radularisaa/Arduino-maze-game/Img/2.jpeg

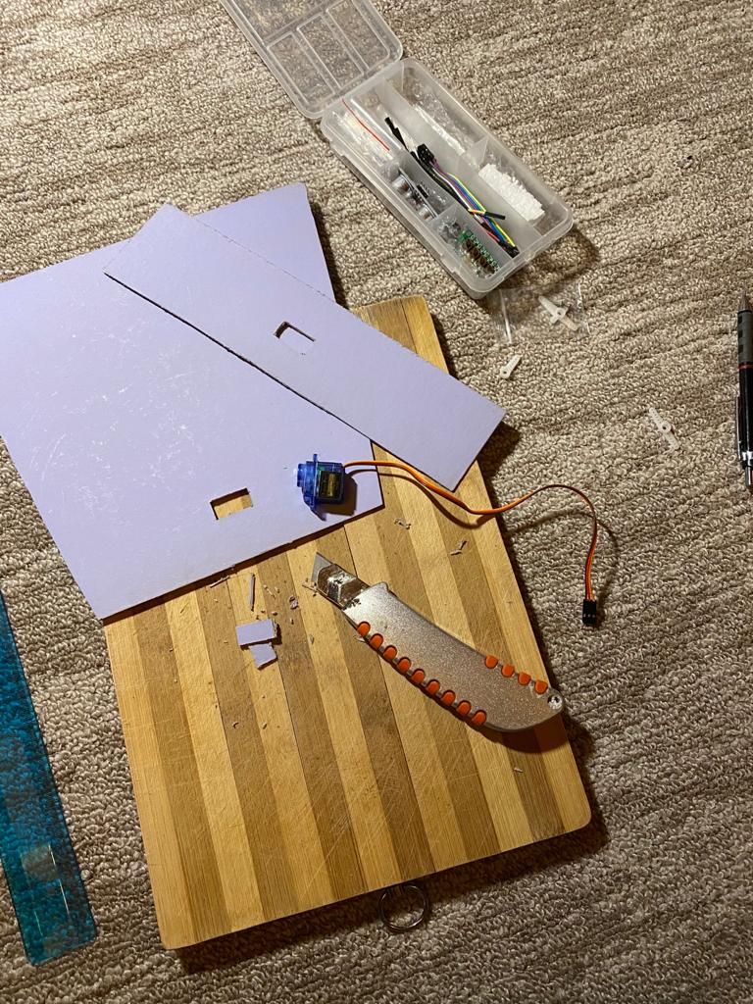
Img/2.jpeg
