radularisaa/Arduino-maze-game/Img/15.jpeg

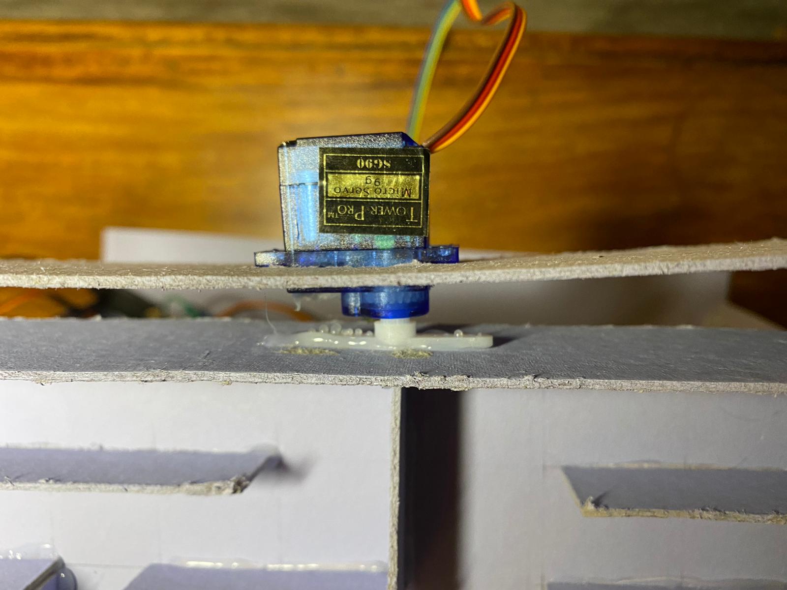
Img/15.jpeg
