radularisaa/Arduino-maze-game/README.md

# Arduino-maze-game

This is a fun maze game made with arduino components and carboard. Enjoy!

Video de prezentare construcție: https://youtu.be/x9sQN4BVw8w 

Video de prezentare funcționare: https://youtu.be/sFMINSDa4Wc 

Video cu explicația codului: https://youtu.be/Gt4K3H8ZN_Y
