radularisaa/Arduino-maze-game/Img/1.jpeg

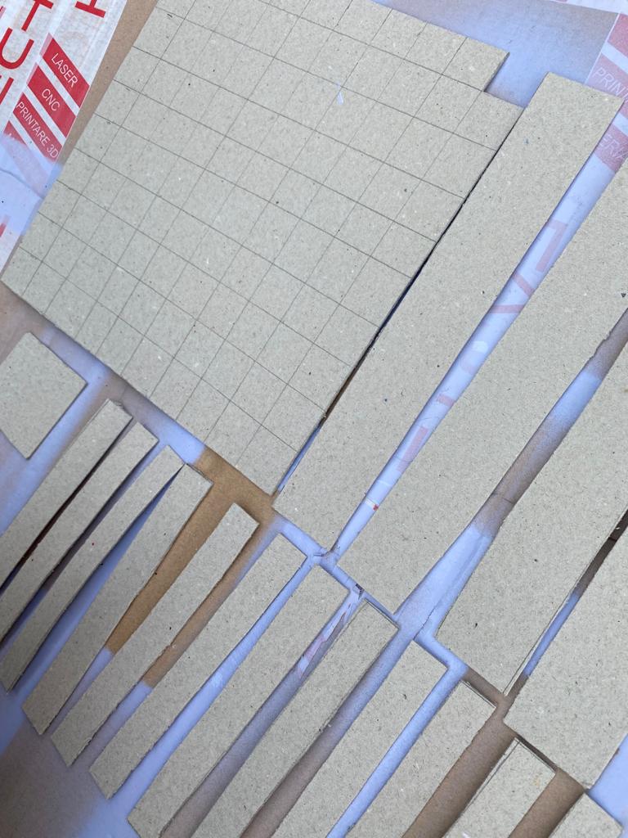
Img/1.jpeg
