radularisaa/Arduino-maze-game/Img/3.jpeg

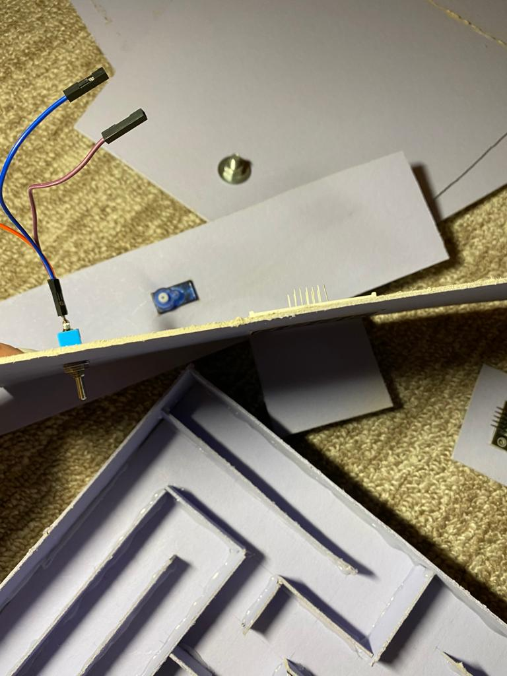
Img/3.jpeg
