radularisaa/Arduino-maze-game/Img/5.jpeg

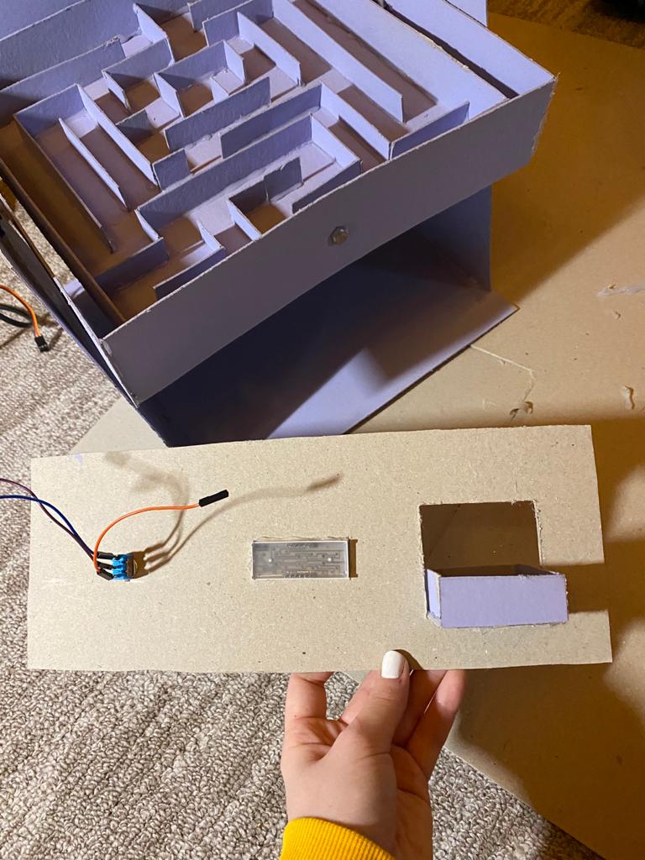
Img/5.jpeg
