radularisaa/Arduino-maze-game/Img/6.jpeg

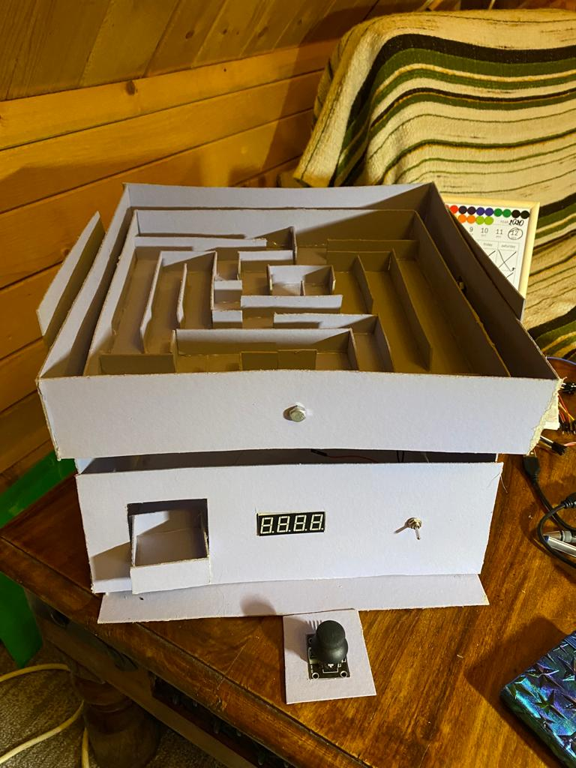
Img/6.jpeg
