radularisaa/Arduino-maze-game/Img/7.jpeg

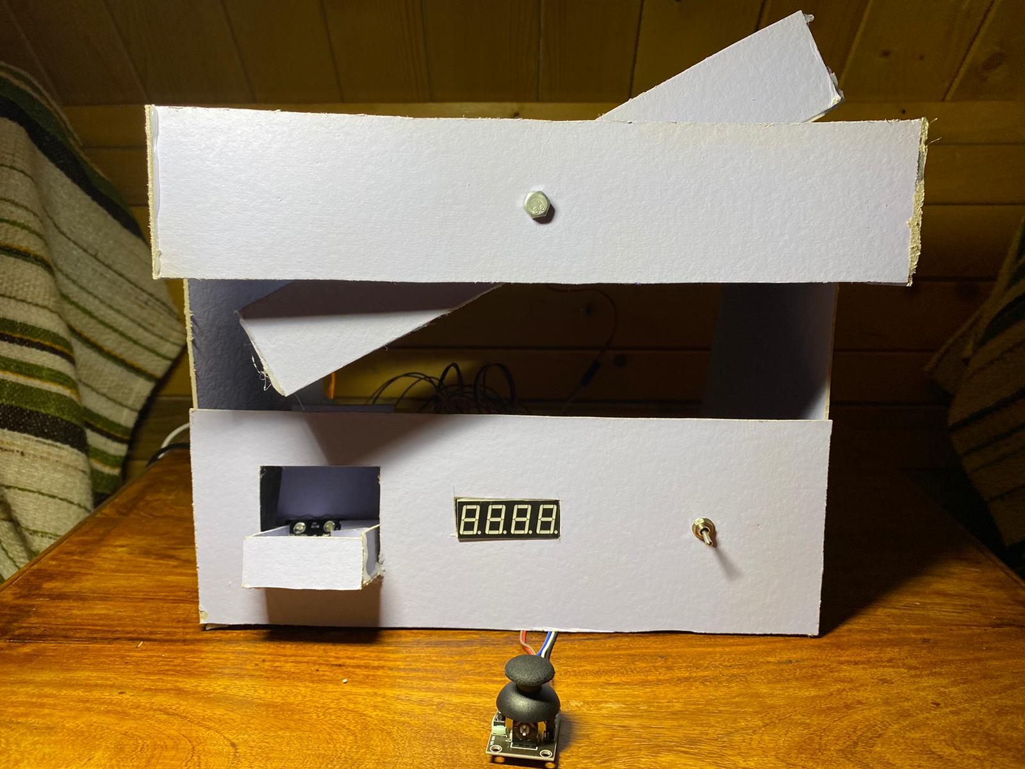
Img/7.jpeg
