radularisaa/Arduino-maze-game/Img/8.jpeg

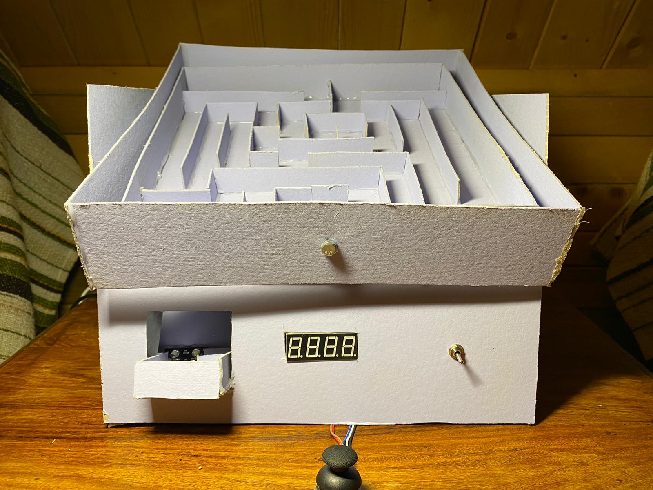
Img/8.jpeg
