radularisaa/Arduino-maze-game/Img/9.jpeg

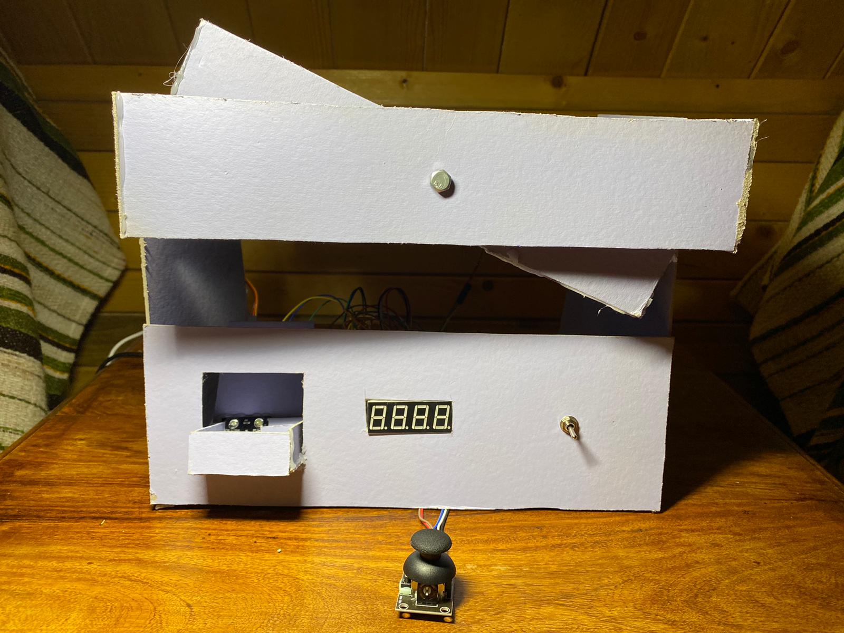
Img/9.jpeg
