radularisaa/Arduino-maze-game/Img/10.jpeg

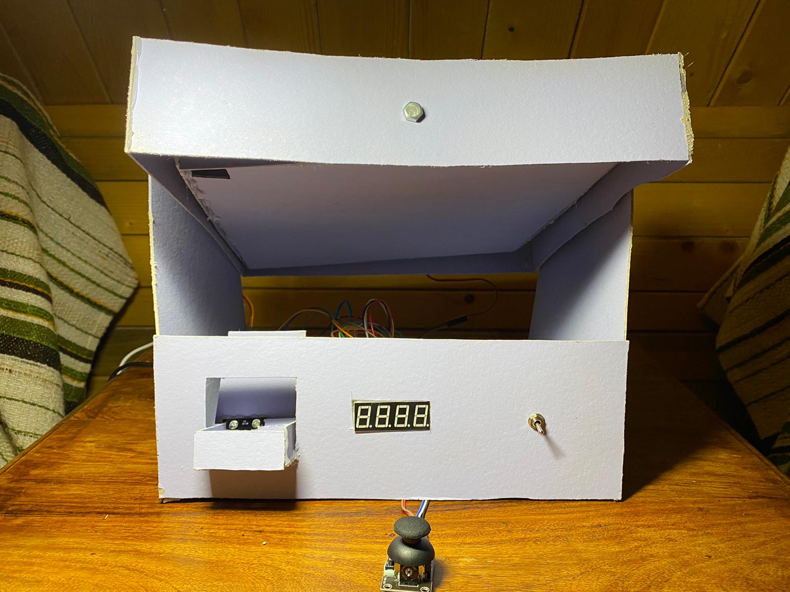
Img/10.jpeg
