radularisaa/Arduino-maze-game/Img/11.jpeg

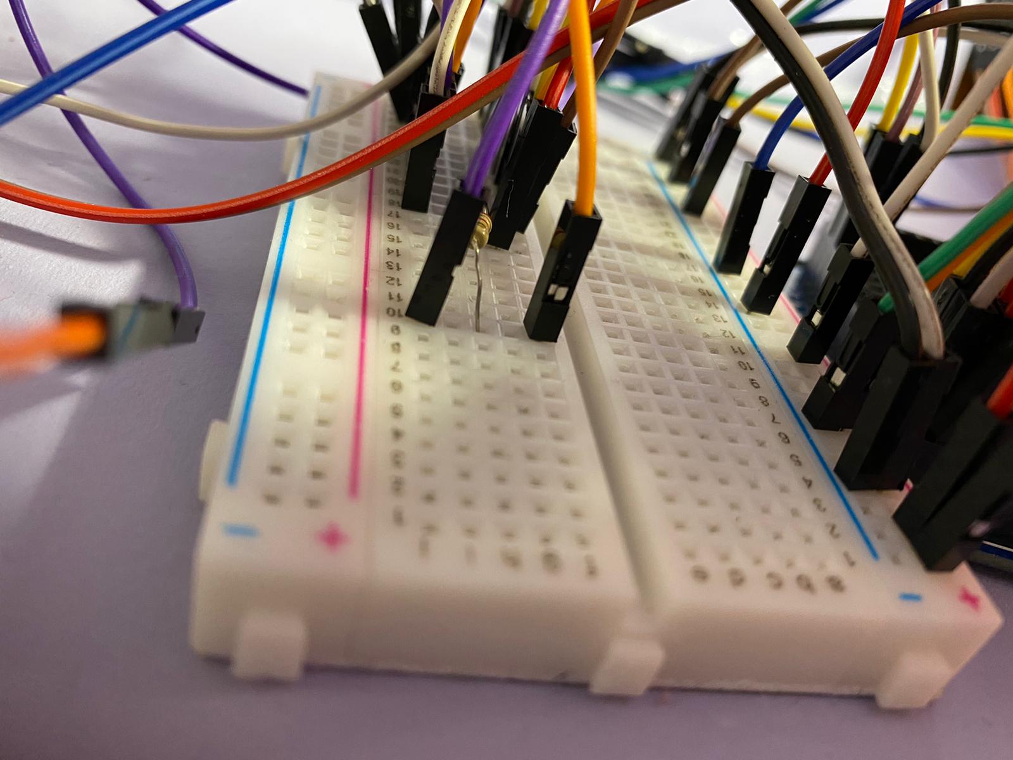
Img/11.jpeg
