radularisaa/Arduino-maze-game/Img/12.jpeg

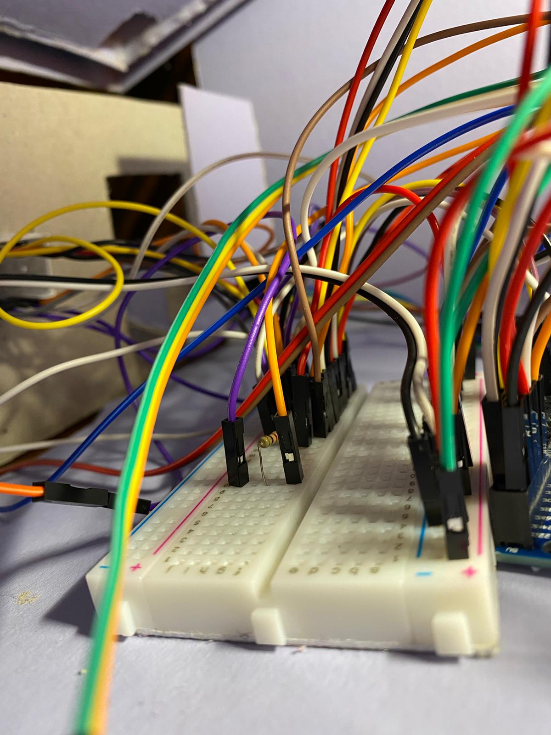
Img/12.jpeg
