radularisaa/Arduino-maze-game/Img/13.jpeg

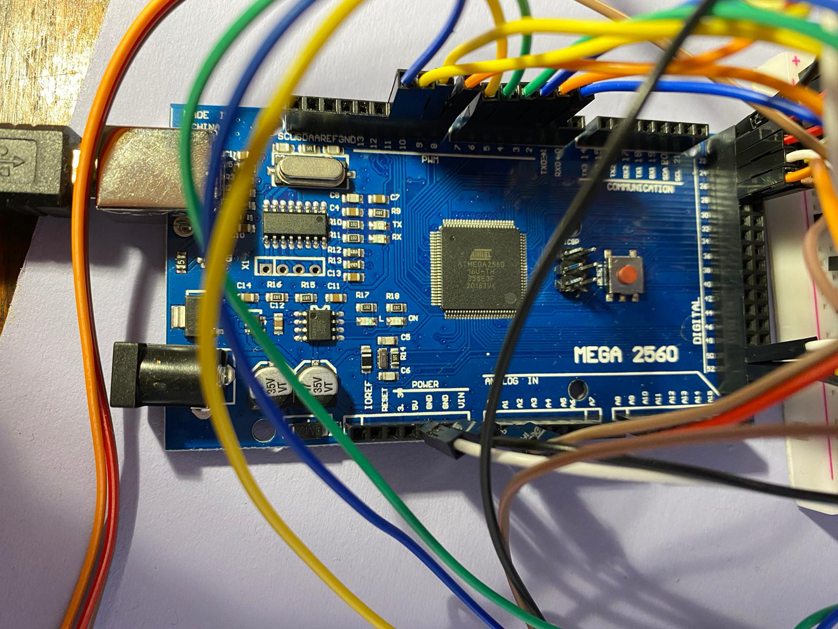
Img/13.jpeg
