radularisaa/Arduino-maze-game/Img/16.jpeg

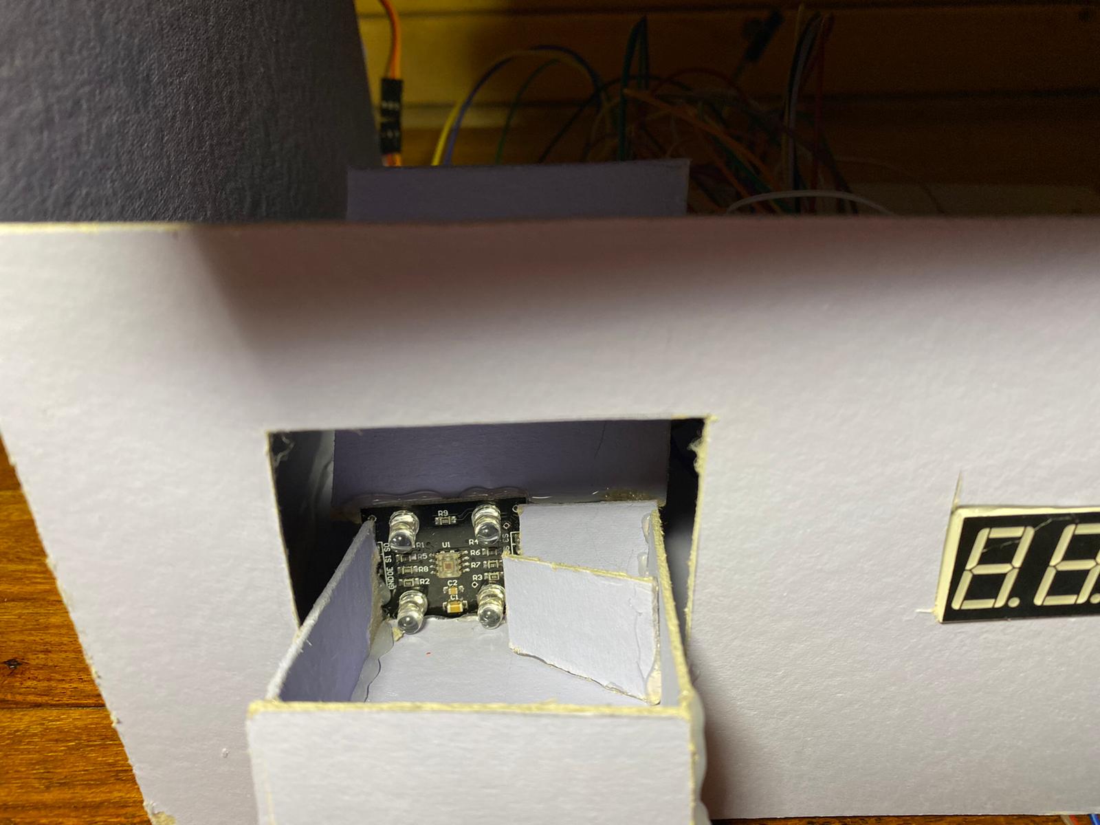
Img/16.jpeg
