radularisaa/Arduino-maze-game/Img/17.jpeg

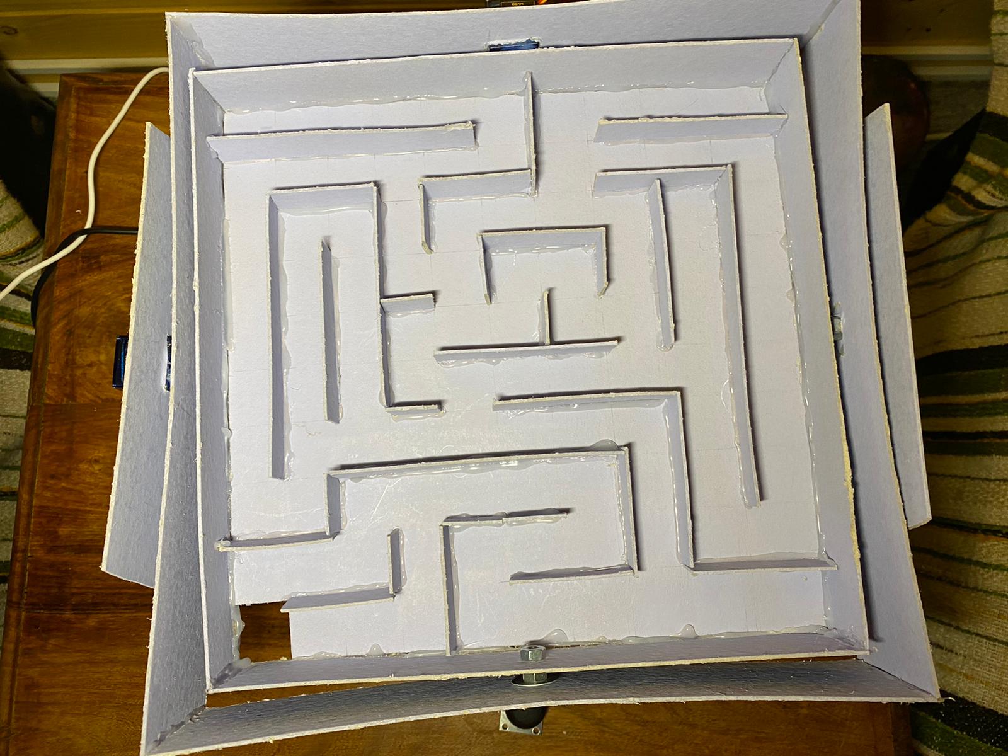
Img/17.jpeg
