radularisaa/Arduino-maze-game/Img/18.jpeg

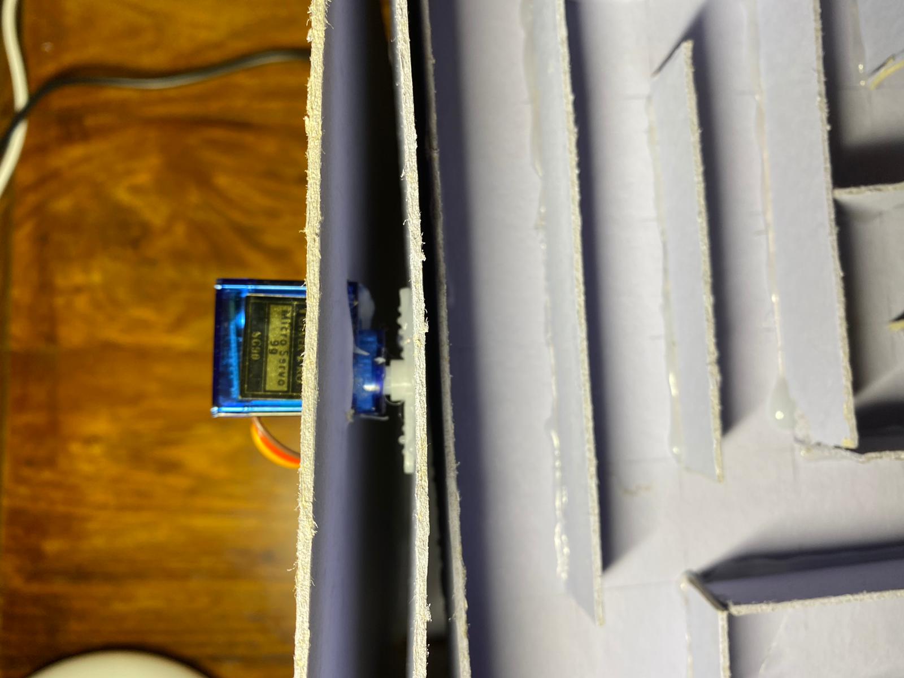
Img/18.jpeg
