radularisaa/Arduino-maze-game/Img/19.jpeg

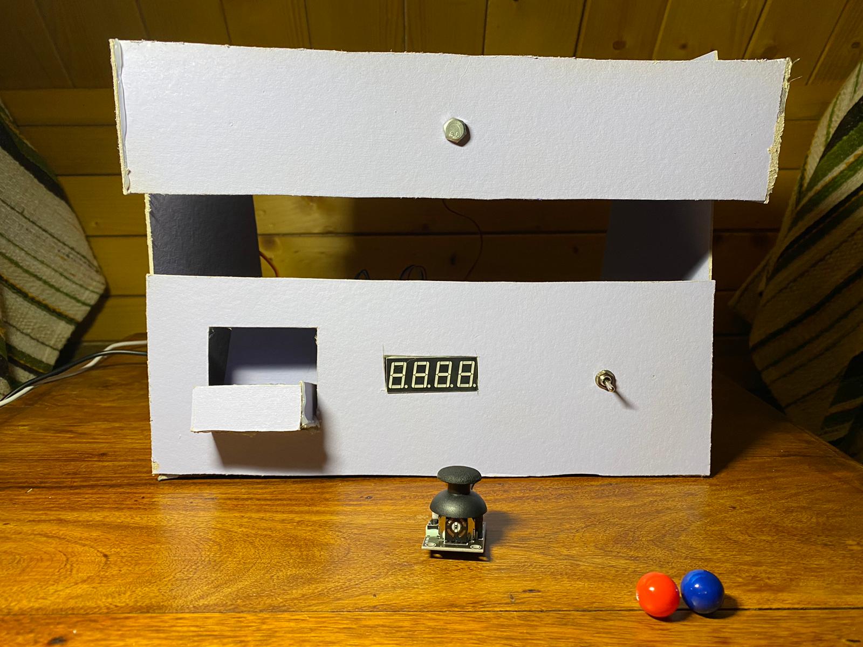
Img/19.jpeg
