radularisaa/Arduino-maze-game/Img/20.jpeg

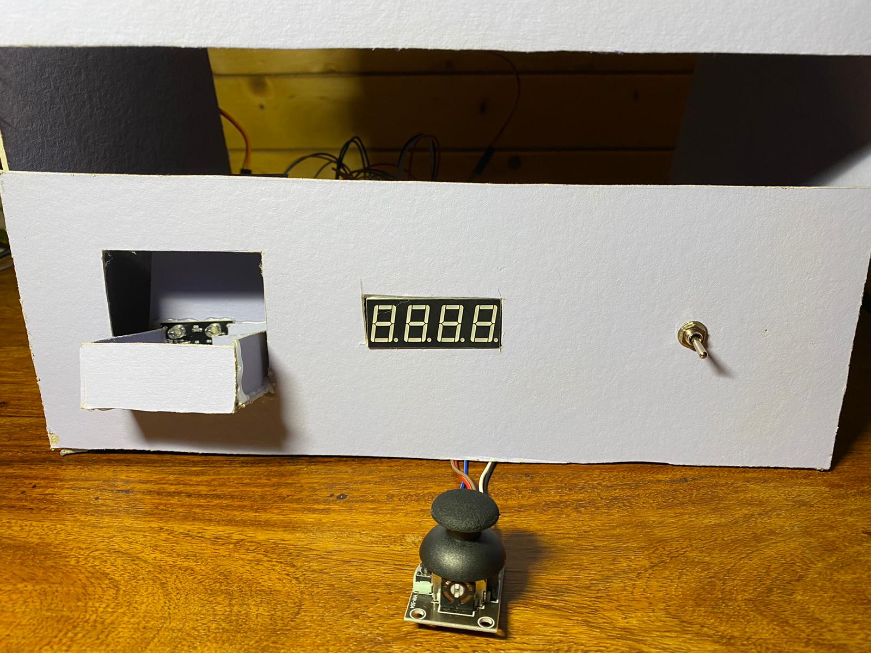
Img/20.jpeg
