radularisaa/Arduino-maze-game/Img/21.jpeg

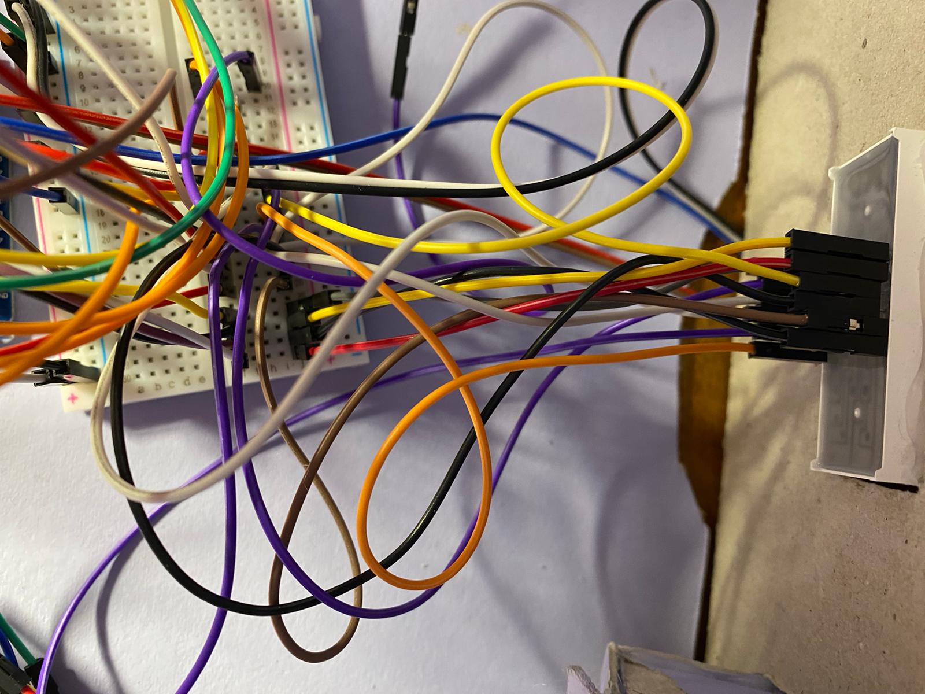
Img/21.jpeg
